microfarad-de/nixie-clock/doc/nixie-clock-schematic.png

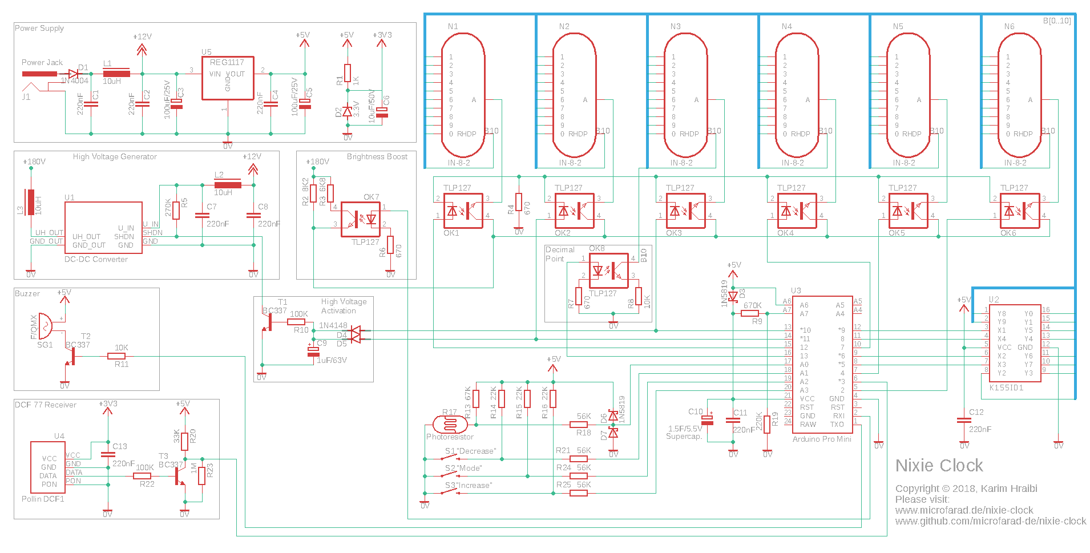
doc/nixie-clock-schematic.png
