microfarad-de/nixie-clock/(commit log)

2018-12-13 Revert "rename files for 1.0.1"
    This reverts commit 149e9e6081cd40d93127afbeffea1f177080385f.
    [Brightness.cpp, Brightness.h, BuildDate.h, Features.cpp, Features.h, Nixie.cpp, Nixie_Clock.ino]
2018-12-13 Resolved all compiler warnings
    [Brightness.cpp, Features.cpp, Features.h]
2018-12-13 Renaming files to lower-case - stage 1
2018-12-13 Renaming files to lower-case - stage 2
2019-01-01 Blanking no longer re-activated at the start of an hour
    [nixie-clock.ino]
2019-01-01 User interface tweaks
    Countdown timer: disable seconds adjustment - feature not really needed
    Stopwatch & countdown timer: reduce timeout to 60minutes
    TimerTwo: remove unused property pwmPeriod
2019-01-01 Optimize countdown timer user interface
    Timer no longer pauses while adjusting the time.
    [features.cpp]
2019-01-01 Countdown timer update
    After the countdown timer expires, it now keeps counting the time in the upward direction.
2019-01-02 Bugfix: fixed distorted alarm sound
    Added license information to the commented headers
    [brightness.cpp, brightness.h, build-date.h, features.cpp, features.h, helper.cpp, helper.h, nixie-clock.ino]
2019-01-10 Improve timeout behavoir of Countdown Timer and Stopwatch
    Return to time display if in Timer or Sotpwatch mode for more than 60 minutes without any activity.
    This does not apply if Timer or Stopwatch are running. In this case, the 60 minutes are counted from the moment when either feature is stopped.
    Refactored code by simplifying conditional statements inside the menu state machine.
2019-02-02 Update bill of material
    [nixie-clock-bill-of-material.csv]
2019-02-04 Debug code for sporadic missed alarm issue
    - Introduced the debug code to display all of the parameters used by the alarm triggering conditional
    - Increased button debounce filter depth
    [features.cpp, features.h, nixie-clock.ino]
2019-02-05 Fixed missed alarm bug, intorduced calendar week
    - Implemented a fix that shall resolve the sporadic missed alarm bug
    - Introduced new display for showing the day of week and calendar week number
    - Introduced a new setting value "7.1" for configuring the first day of the week
    [features.cpp, features.h, nixie-clock.ino]
2019-02-05 Fixed wrong default value, changed menu item 7.1 to 6.2
    [nixie-clock.ino]
2019-02-08 Fixed race condition during buttons 1 and 2 long press
    [nixie-clock.ino]
2019-04-17 Minor improvments
    - Set the intial Nixie tube uptime value on compile time
    - Disable ADC prior to deep sleep
    - Update user manual
2019-06-20 Update and rename adc.cpp to Adc.cpp
2019-06-20 Update and rename adc.h to Adc.h
2019-06-20 Reset all settings to default upon initial boot
    [nixie-clock.ino]
2019-07-03 Dcf: potential bug fix
    - Dcf: enter critical sections when accessing dcfBit as an attempt to debug occasional timer calibration 20ppm error
    - Refactor
    [nixie-clock.ino]
2019-07-14 Fixed time adjustment inaccuracy
    1 second needs to be subtracted from the DCF time in order to compensate for the initial second tick interrupt. Failing to do so caused the time to be off by 1 second and resulted in a faultiy Timer1 calibration.
    [nixie-clock.ino]
2019-08-15 Bugfix: return to clock mode
    When in timer or stopwatch mode for more than 5 seconds, perssing the "menu" button should bring pack the clock mode. This did not work while the timer or stopwatch is active.
    [nixie-clock.ino]
2019-08-15 Bugfix: deactivate debug values
    Set the number of debug values to 0 upon their deactivation.
    [nixie-clock.ino]
2020-01-28 Added versions archived prior to moving to GitHub
    [Cycle_Analysis.xlsx]
2020-03-12 Updated Adc
2020-03-12 Introduced the button module
2020-03-12 Switch Button submodule to master branch
2020-03-12 Removed archive folder (contents moved to archive branch)
    [Cycle_Analysis.xlsx]
2020-03-12 Integrated Arduino-Makefile
2021-01-03 Updated .gitmodules to arduino-library
2021-01-03 Implement dynamic timer period adjustment
2021-01-09 Increased auto-calibration accuracy to 1/10 of a microsecond
2021-01-09 Enable incremental adjustment of the clock drift (setting 6.1)
    [nixie-clock.ino]
2021-01-09 Check if timer period is within boundaries
2021-01-09 Set the manuallyAdjustd flag upon manual clock drift adjustment
    [nixie-clock.ino]
2021-01-09 Improve digit scrolling behavior Improve button debounce behavior
2021-01-09 Increase timer precision by setting TIMER1_DIVIDER to 64
2021-01-10 Improved countdown timer button behavior
2021-01-10 Visual feedback upon long pressing the o button Refactoring
2021-01-10 Rework countdown timer operation logic
    [Features.cpp, nixie-clock.ino]
2021-01-11 Increase dynamic timer adjustment precision
2021-01-12 Improved countdown timer behavior Refactored variable names
2021-01-13 Reviewed volatile variables Refactored macro name Correct initialization of timerPeriod
    [Features.cpp, Features.h, nixie-clock.ino]
2021-01-14 Service value 1 now displays <Timer1 period in µs>.<fractional part> Improve Nixie uptime reset value initialization
    [nixie-clock.ino]
2021-01-17 Inverted DCF signal indicator decimal point
    [nixie-clock.ino]
2021-01-19 Fixed serial debug build
    [nixie-clock.ino]
2021-08-23 Fixed an error in the schematic.
2021-10-31 Blink once we resetting alarm
    [nixie-clock.ino]
2023-02-06 Changed system time to UTC Fixed integer overflow error
    [nixie-clock.ino]
2023-02-06 Changed time setting order to sec -> hour -> min -> year -> month -> day -> week Bugfixes
    [nixie-clock.ino]
2023-02-06 Modified second set behavior Increment by 1 minute if seconds value upon reset was >= 30
    [nixie-clock.ino]
2023-02-06 Revert "Changed time setting order to"
    This reverts commit 01d2301aab533e1613d88194d98dda30fa914987.
    [nixie-clock.ino]
2023-02-06 Prevent month day overflow while setting month and year
    [nixie-clock.ino]
2023-02-06 Improved button debouncing Increased IIR filter length from 16 to 32
2023-02-06 Indentation and typo fixes
    [nixie-clock.ino]
2023-03-26 Fixed bug that prevented auto DST from working.
    [nixie-clock.ino]
2024-02-06 Updated Nixie Clock schematic Fixed wrong capacitor polarity
2024-02-06 Cropped Nixie Clock schematic
2026-04-03 Implemented automatic daylight saving correction algorithm for EU
    [nixie-clock.ino]
